RoboticExplorationLab/Acrobot/images_for_documentation/D6374_mount.png

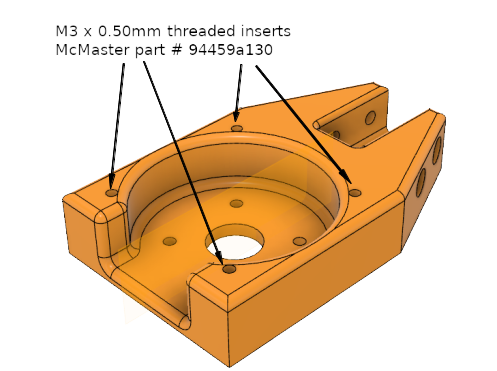
images_for_documentation/D6374_mount.png
