RoboticExplorationLab/Acrobot/images_for_documentation/acrobot_complete_3.png

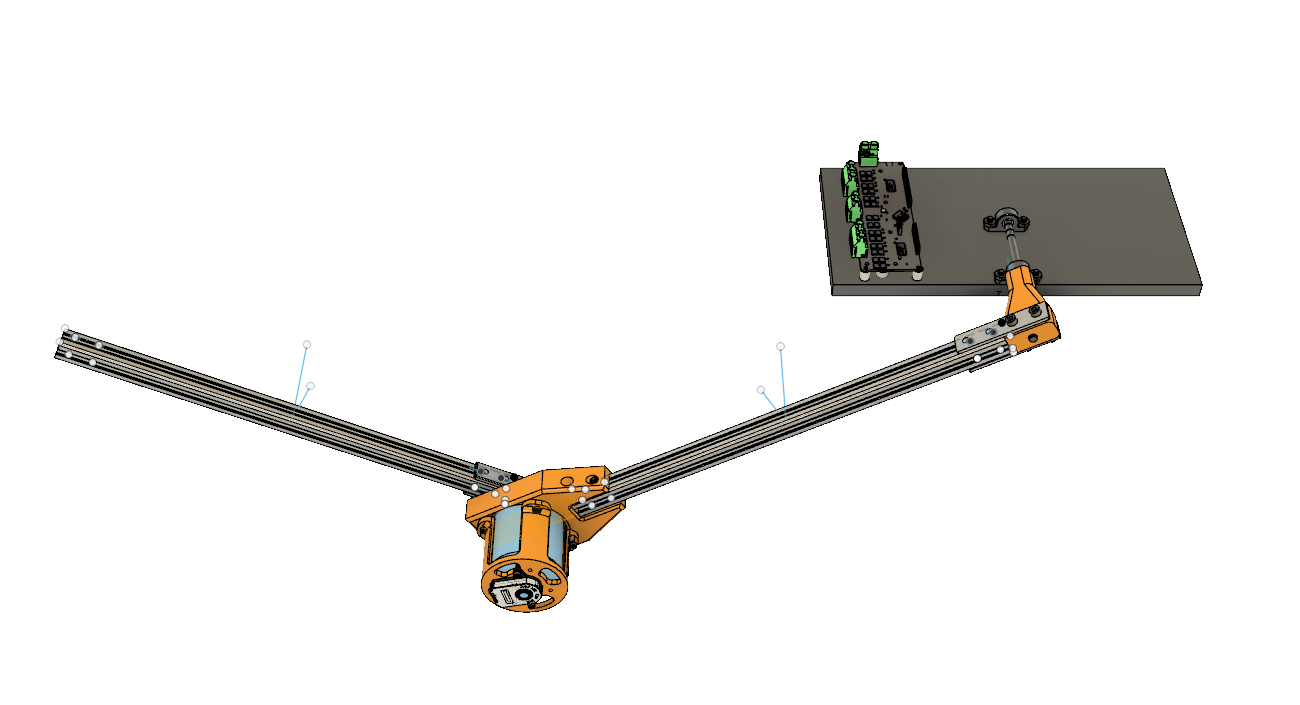
images_for_documentation/acrobot_complete_3.png
