RoboticExplorationLab/Acrobot/images_for_documentation/acrobot_complete_4.png

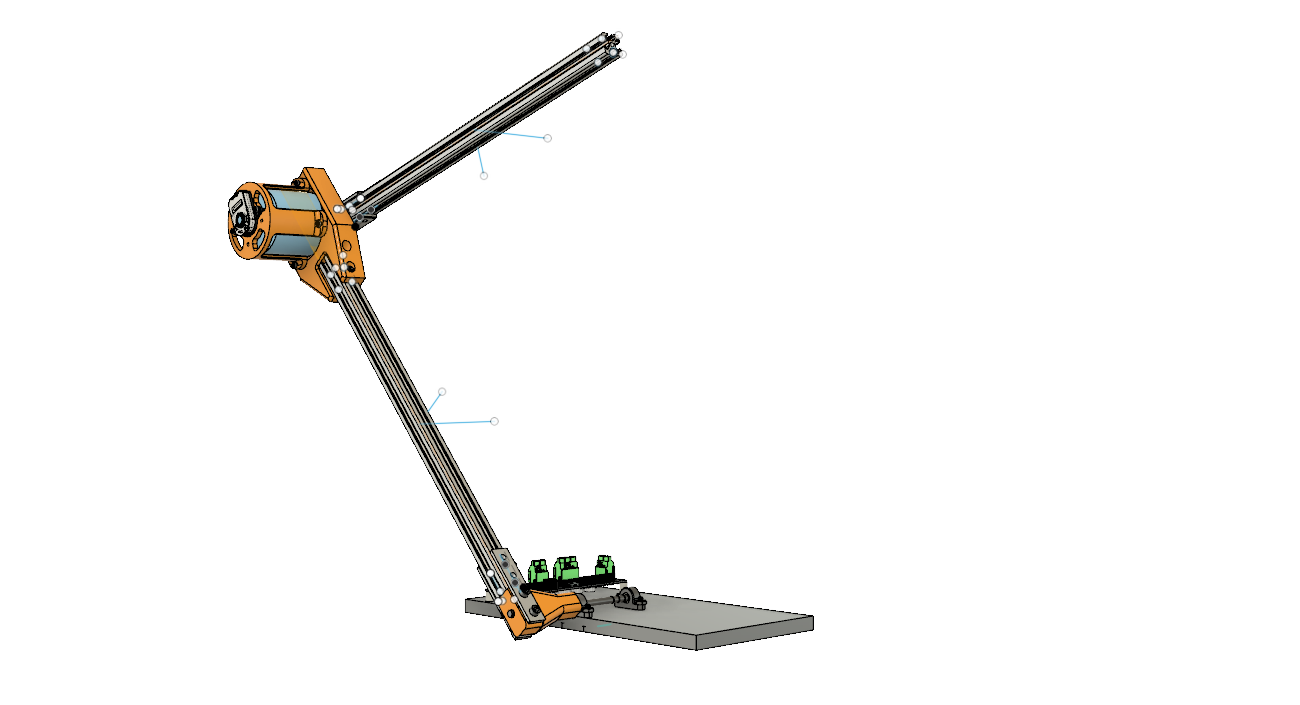
images_for_documentation/acrobot_complete_4.png
