RoboticExplorationLab/Acrobot/images_for_documentation/acrobot_complete_upright_1.png

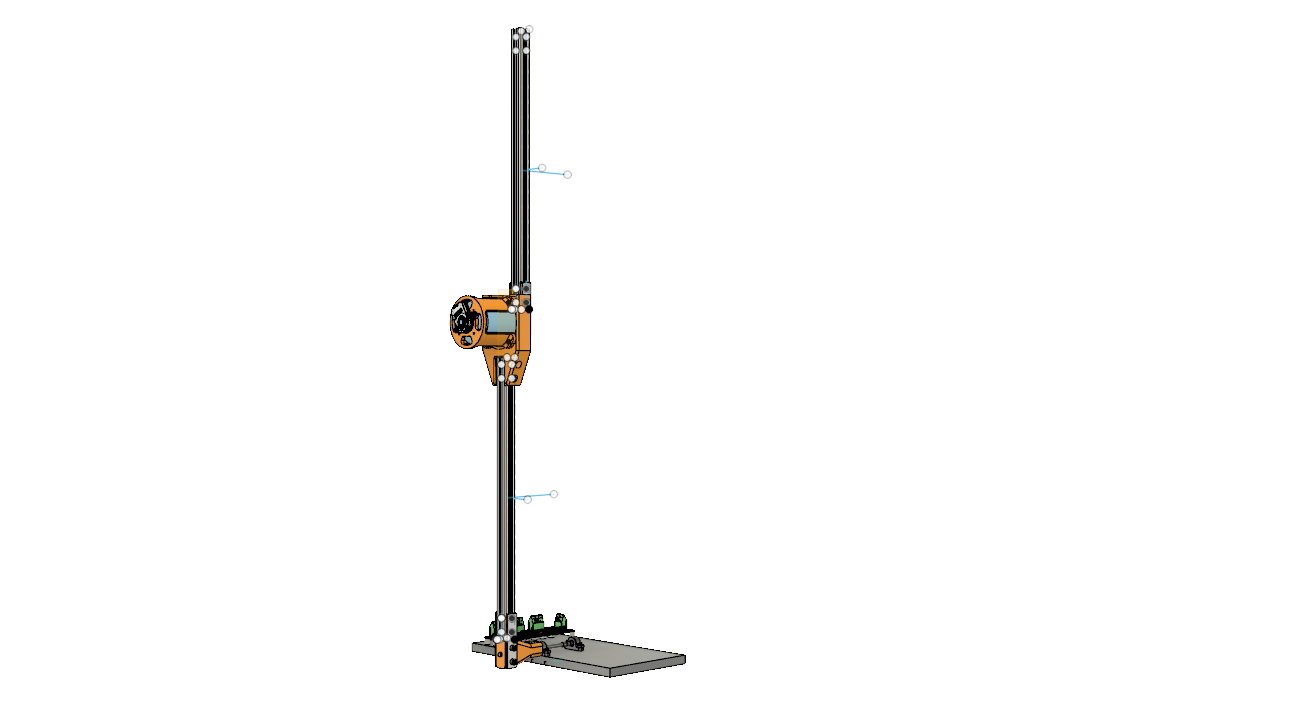
images_for_documentation/acrobot_complete_upright_1.png
