RoboticExplorationLab/Acrobot/images_for_documentation/bearing_mount_arm.png

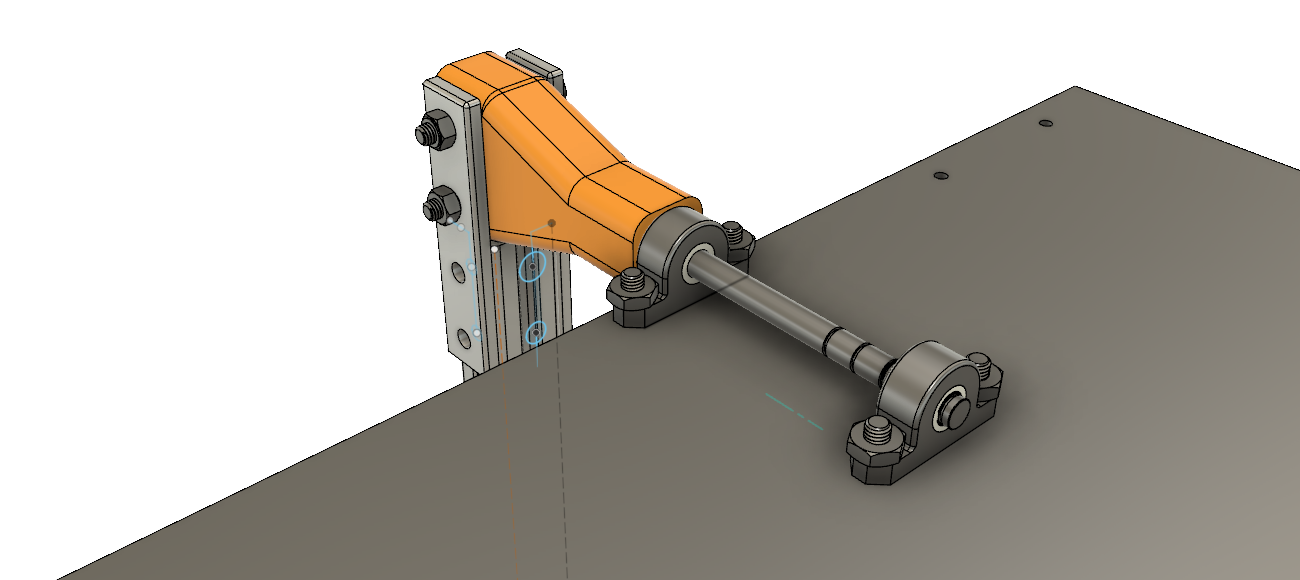
images_for_documentation/bearing_mount_arm.png
