RoboticExplorationLab/Acrobot/images_for_documentation/encoder_bracket.png

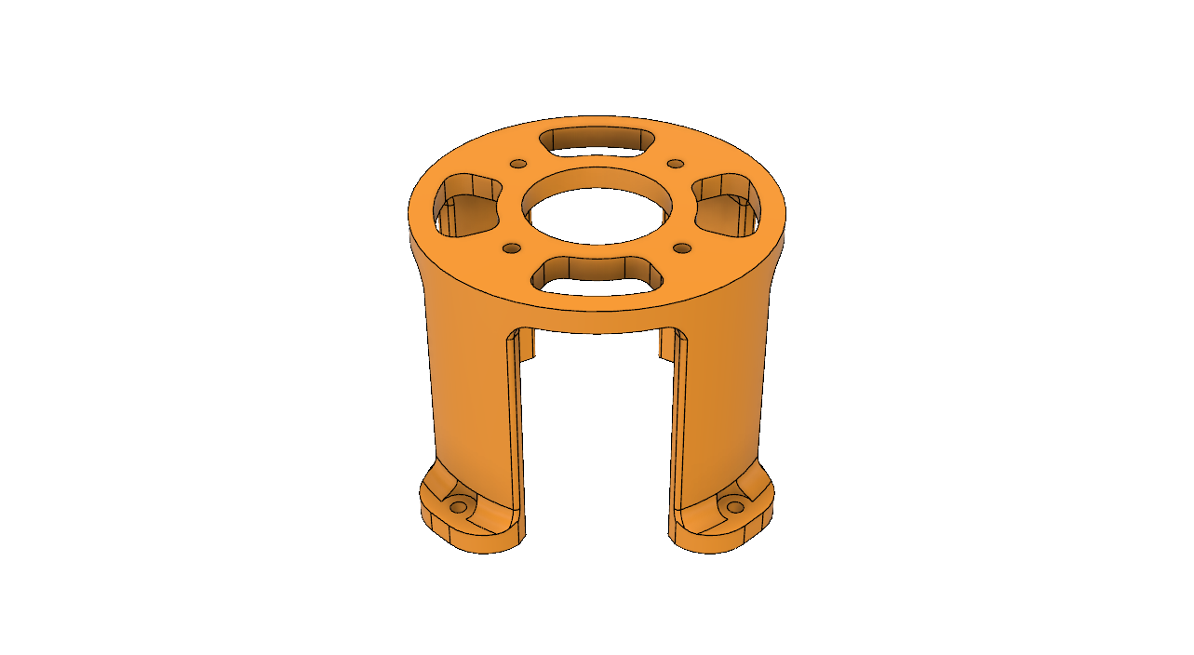
images_for_documentation/encoder_bracket.png
