RoboticExplorationLab/Acrobot/images_for_documentation/motor_arm_mount.png

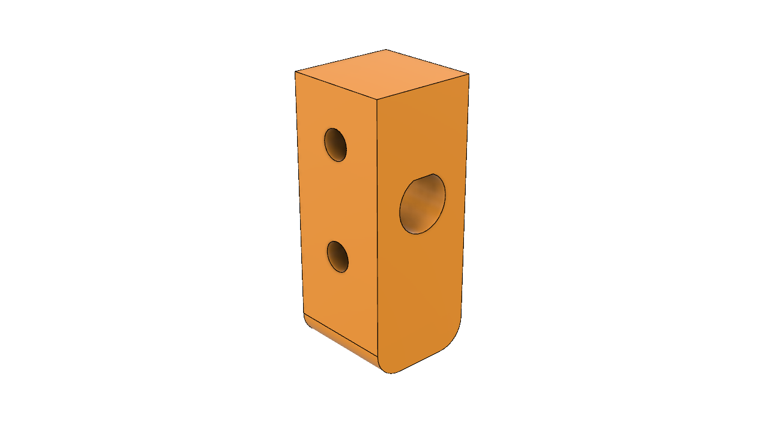
images_for_documentation/motor_arm_mount.png
