RoboticExplorationLab/Acrobot/images_for_documentation/motor_mount_5.png

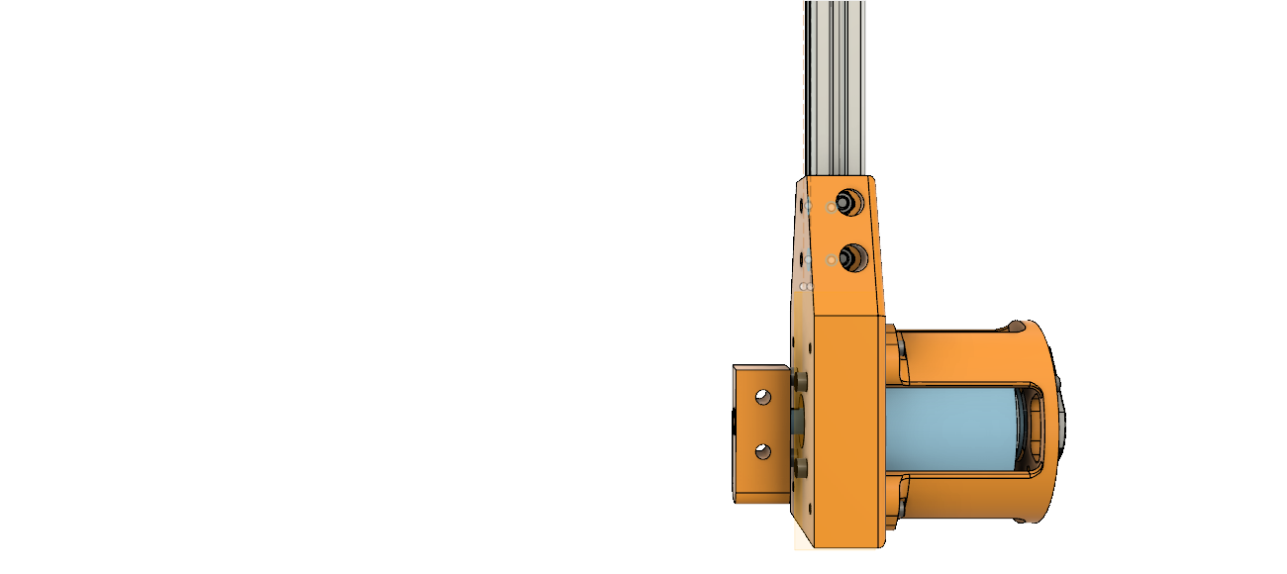
images_for_documentation/motor_mount_5.png
