RoboticExplorationLab/Acrobot/images_for_documentation/motor_mount_6.png

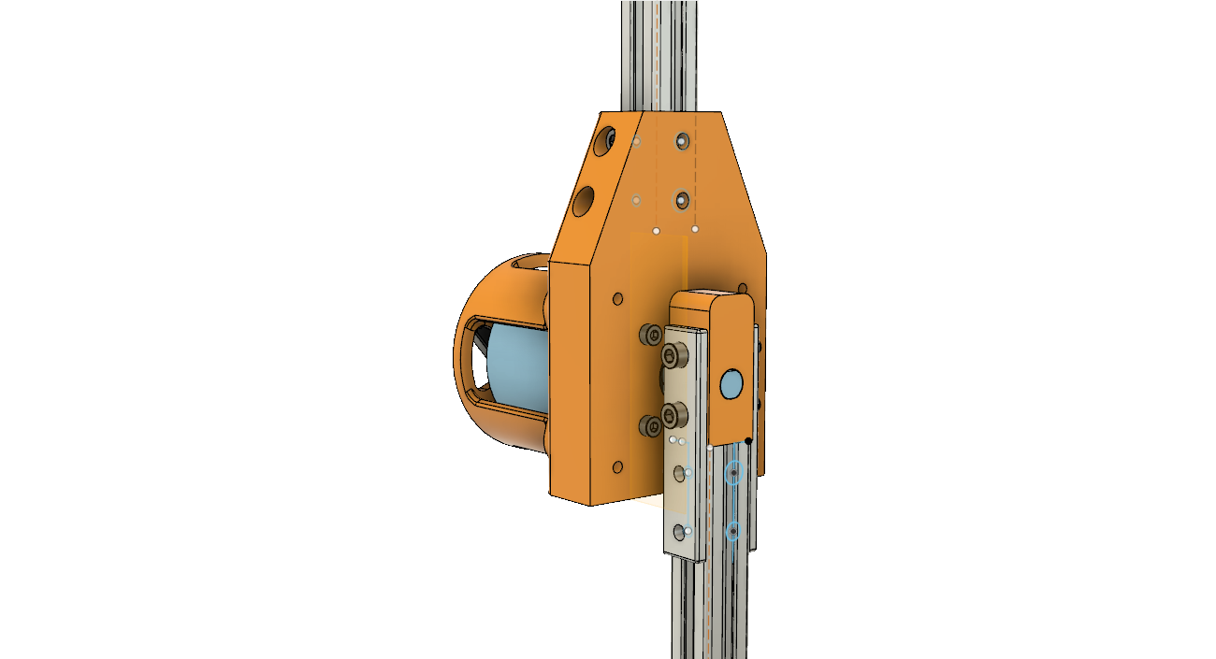
images_for_documentation/motor_mount_6.png
