RoboticExplorationLab/Acrobot/images_for_documentation/rod_mount.png

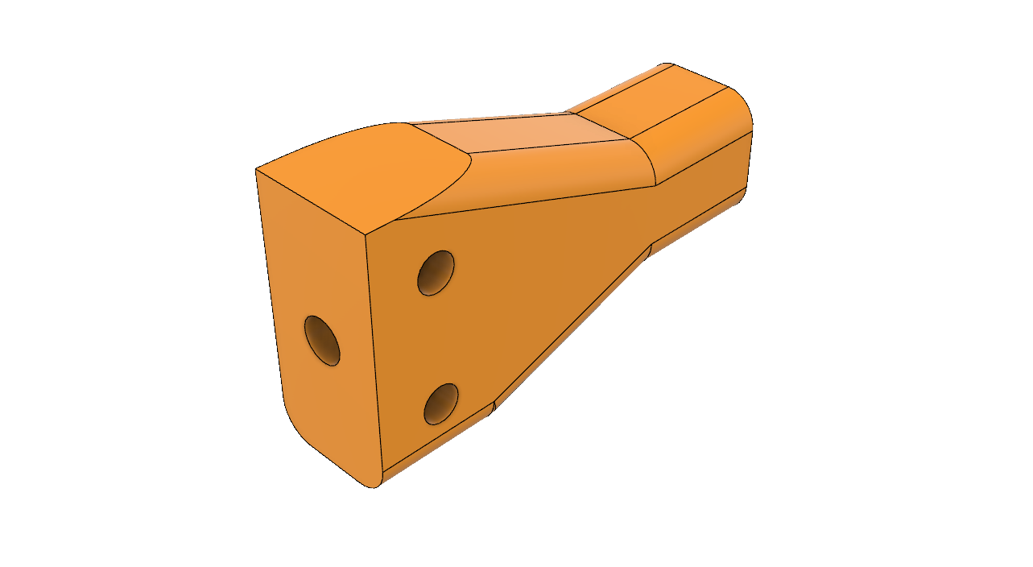
images_for_documentation/rod_mount.png
