RoboticExplorationLab/Acrobot/Acrobot_BOM_winter_2019.xlsx

Part | Supplier | Part# | Price (each) | Qty | Options | Total | Link
T-Slotted Framing, Single Four Slot Rail, Silver, 20 mm Square, Solid | McMaster | 5537T101 | $10.38 | 1 | 3ft. length | $10.38 | https://www.mcmaster.com/5537T101 |  | 5537T101 | 1
T-Slotted Framing Extended Straight Bracket for 20 mm High Rail, 3" Long | McMaster | 5537T948 | $10.25 | 6 |  | $61.50 | https://www.mcmaster.com/5537t948 |  | 5537T948 | 6
Dual Shaft Motor - D6374 150kv | ODrive | D6374 | 99 | 1 |  | $99.00 | https://odriverobotics.com/shop/odrive-custom-motor-d6374-150kv
ODrive v3.6 | ODrive | 3.6 | 119 | 1 |  | $119.00 | https://odriverobotics.com/shop/odrive-v36
8192 CPR Encoder with Cable (CUI AMT102-V) | ODrive | 8192 | $39.00 | 1 |  | $39.00 | https://odriverobotics.com/shop/cui-amt-102
Ultra-Low-Friction Dry-Running Sleeve Bearing | McMaster | 6377K32 (https://www.mcmaster.com/6377K32) | 3.08 | 2 |  | $6.16 | https://www.mcmaster.com/friction-bearings |  | 6377K32 | 2
Bearing Housing for 3/8" Wide and 0.375" OD Bearing | McMaster | 2829N1 (https://www.mcmaster.com/2829N1) | $9.98 | 2 |  | $19.96 | https://www.mcmaster.com/standard-mounted-bearings |  | 2829N1 | 2
303 Stainless Steel Rotary Shaft with Retaining Ring Grooves, 6" | McMaster | 2025K200 | $6.72 | 1 |  | $6.72 | https://www.mcmaster.com/2025k2 |  | 2025K200 | 1
91290A1959 SOCKET HEAD CAP SCREW M5 35mm pack of 10 | McMaster | 91290A195 | $7.67 | 1 |  | $7.67 | https://www.mcmaster.com/91290a195 |  | 91290A195 | 1
Spiral External Retaining Rings for 1/4" OD, 1060-1090 Spring Steel pkg of 25 | McMaster | 94540A300 | $8.20 | 1 |  | $8.20 | https://www.mcmaster.com/94540A300 |  | 94540A300 | 1
Steel Hex Nut, Medium-Strength, Class 8, M5 x 0.8 mm Thread, pkg of 100 | McMaster | 90592A095 | $1.76 | 1 |  | $1.76 | https://www.mcmaster.com/90592A095 |  | 90592A095 | 1
Motor mount, 3D printed | PRL Lab | N/A | pending | 1 |  | pending | these 2 items were like $9.96
Encoder mount, 3D printed | PRL Lab | N/A | pending | 1 |  | pending
Motor-arm connector, 3D printed | PRL Lab | N/A | pending | 1 |  | pending | these 2 items maybe $2.??
Shaft connector, 3D printed | PRL Lab | N/A | pending | 1 |  | pending
Low-Profile C-Clamp, Standard, 0" to 1-1/2" Opening | McMaster | 1705A11 | $8.80 | 2 |  | $17.60 | https://www.mcmaster.com/1705A11 |  | 1705A11 | 2
Multipurpose 6061 Aluminum, 1/2" Thick x 6" Wide | McMaster | 8975K219 | $30.44 | 1 | 1ft. length | $30.44 | https://www.mcmaster.com/8975K219 | Bottom plate | 8975K219 | 1
Black-Oxide Alloy Steel Socket Head Screw 10-32 Thread Size, 3/4" Long, pkg of 100 | McMaster | 91251A345 | $11.24 | 1 |  | $11.24 | https://www.mcmaster.com/91251a345 | these are for mounting the bearings | 91251A345 | 1
Low-Strength Steel Hex Nut, Zinc-Plated, 10-32, pkg of 100 | McMaster | 90480A195 | $1.89 | 1 |  | $1.89 | https://www.mcmaster.com/90480A195 | these are for mounting the bearings | 90480A195 | 1
Black-Oxide Alloy Steel Socket Head Screw M3 x 0.5 mm Thread, 10 mm Long, pkg of 100 | McMaster | 91290A115 | $7.62 | 1 |  | $7.62 | https://www.mcmaster.com/91290a115 | for encoder mount / etc. | 91290A115 | 1
Brass Heat-Set Inserts for Plastic M3 x 0.50 mm Thread Size, 4.300 mm length pkg of 50 | McMaster | 94459a130 | $9.57 | 1 |  | $9.57 | https://www.mcmaster.com/94459a130 | for encoder mount / etc. | 94459a130 | 1
 |  |  |  |  |  | $457.71
