RoboticExplorationLab/Acrobot/printing_stl/motor_arm_mount v7.stl

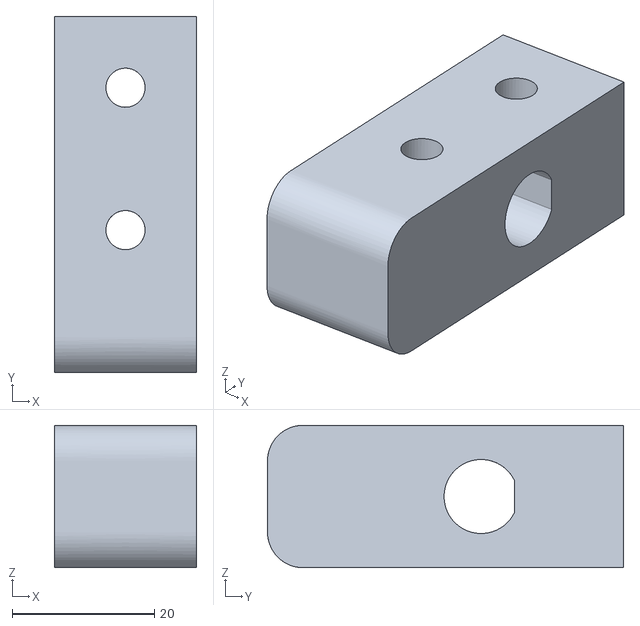
[picture p14: CAD file, 2020-03-20]
printing_stl/motor_arm_mount v7.stl
20.0 x 50.0 x 20.0
