RoboticExplorationLab/Acrobot/printing_stl/rod_mount v9.stl

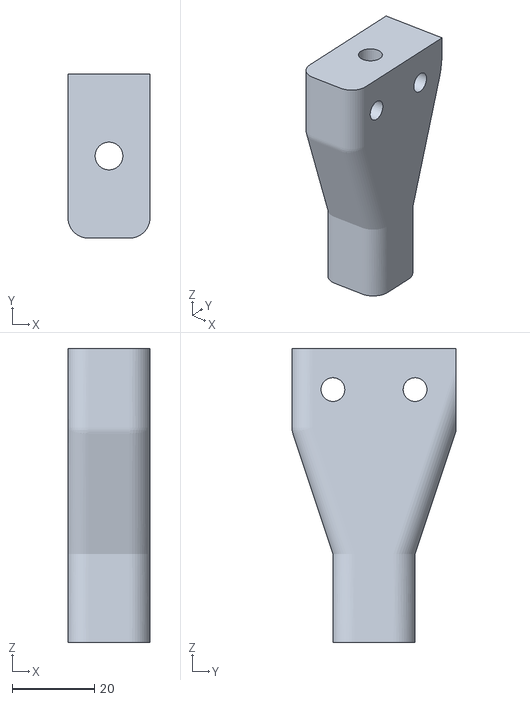
[picture p15: CAD file, 2020-03-20]
printing_stl/rod_mount v9.stl
20.0 x 40.0 x 71.6
