RoboticExplorationLab/Acrobot/printing_stl/encoder_bracket v19.stl

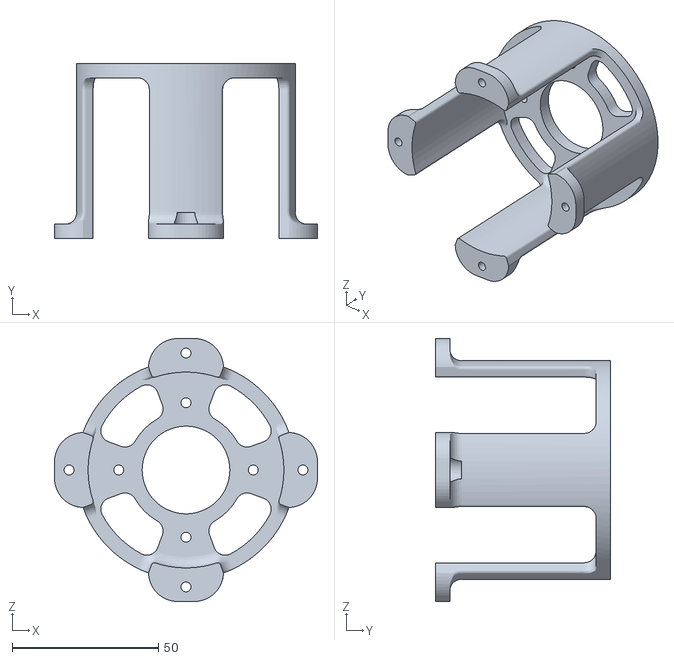
[picture p16: CAD file, 2020-03-20]
printing_stl/encoder_bracket v19.stl
90.0 x 60.0 x 90.0
