RoboticExplorationLab/Acrobot/printing_stl/D6374_mount v22.stl

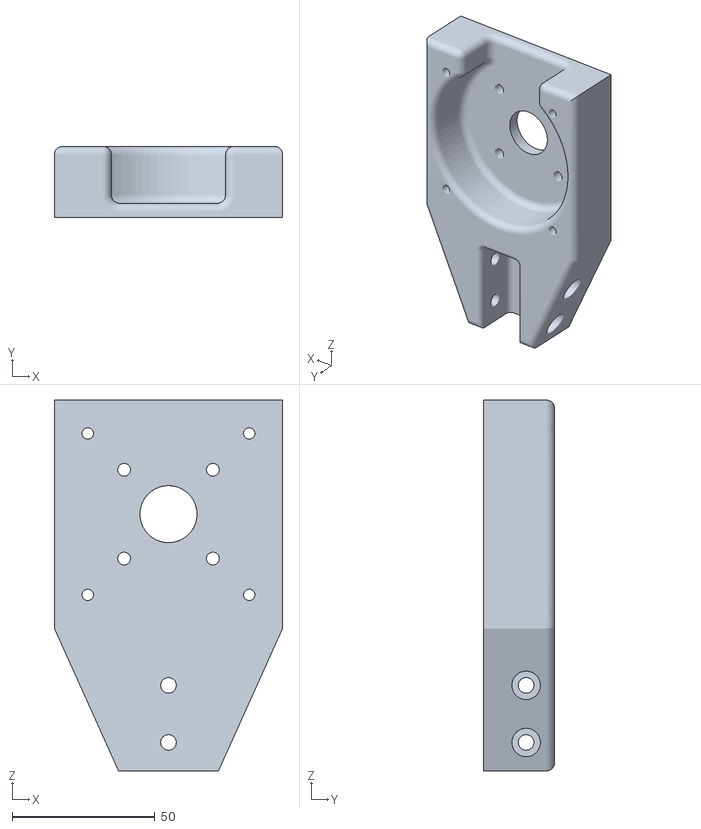
[picture p17: CAD file, 2020-03-20]
printing_stl/D6374_mount v22.stl
80.0 x 25.0 x 130.0
