RoboticExplorationLab/Acrobot/baseplate_drawing.pdf

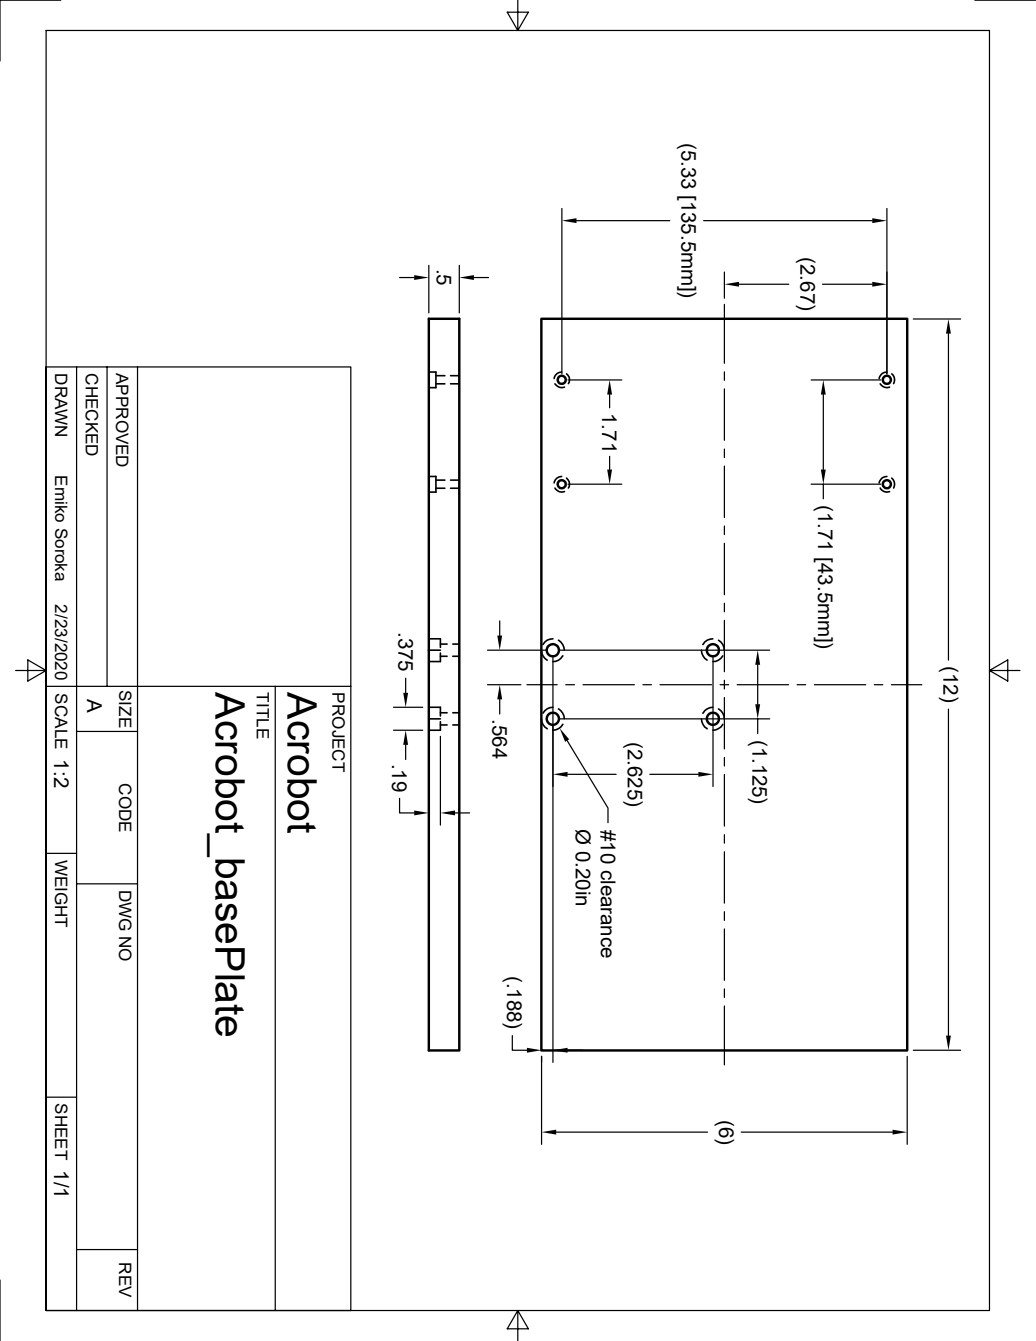
[picture p18: page 1]

TITLE PROJECT DRAWN CHECKED APPROVED SCALE WEIGHT SHEET DWG NO REV CODE SIZE 1/1 1:2 2/23/2020 Emiko Soroka A Acrobot_basePlate Acrobot (12) (6) (2.625) (1.125) (.188) (1.71 [43.5mm]) (5.33 [135.5mm]) (2.67) .5 .564 Ø 0.20in #10 clearance .19 .375 1.71
