RoboticExplorationLab/Acrobot/images_for_documentation/bearing_assembly.png

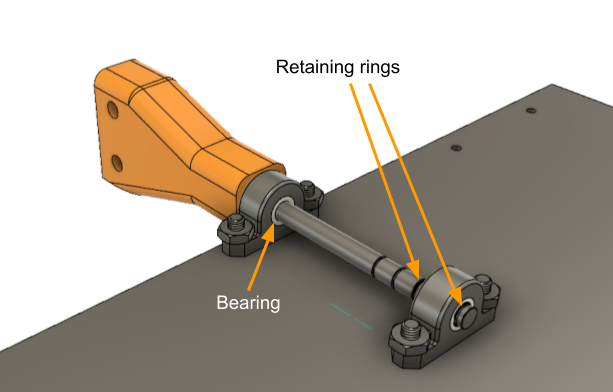
images_for_documentation/bearing_assembly.png
