RoboticExplorationLab/Acrobot/images_for_documentation/bearing_assembly_2.png

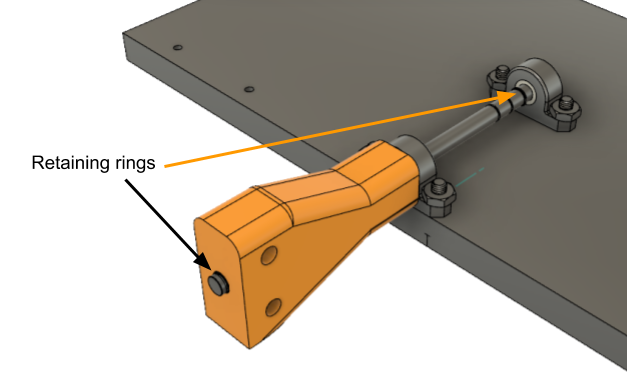
images_for_documentation/bearing_assembly_2.png
