RoboticExplorationLab/Acrobot/images_for_documentation/motor_assembly_3.png

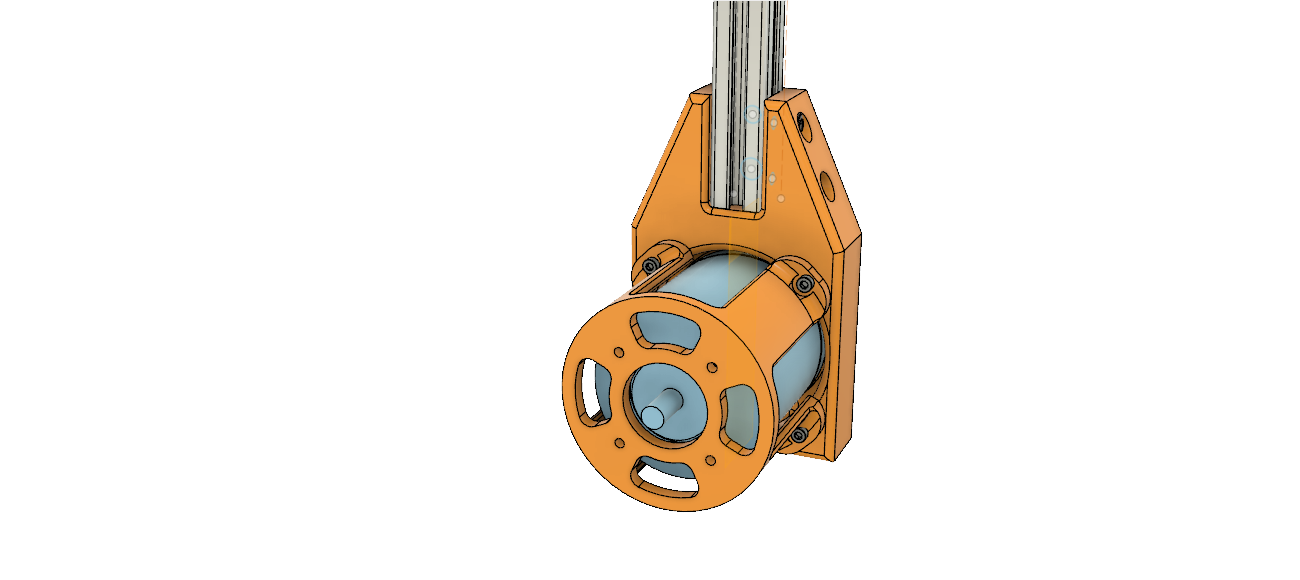
images_for_documentation/motor_assembly_3.png
