RoboticExplorationLab/Acrobot/(commit log)

2020-03-20 Acrobot CAD, update over spring break
2020-03-20 BOM with parts that were *actually purchased*
    [Acrobot_BOM_winter_2019.xlsx]
2020-03-20 Latest STL versions (these were actually printed and verified to work). Can't update anyway because Stanford printing services are currently closed.
    [D6374_mount v22.stl, encoder_bracket v19.stl, motor_arm_mount v7.stl, rod_mount v9.stl]
2020-03-21 Drawing for baseplate mounting holes
2020-03-21 Updated the CAD zip file.
2020-03-21 Added a note on where to put the threaded inserts.
2020-03-21 trying again on that threaded insert note
2020-03-21 forgot these 3 assembly pics
2020-03-21 Removed unnecessary files and added a video clip of completed mechanical assembly.
